pull-up-dev/tuto-kicad-temp-logger/tuto-kicad-temp-logger.kicad_pcb

## KiCad design tuto-kicad-temp-logger.kicad_pcb (2024-08-25)

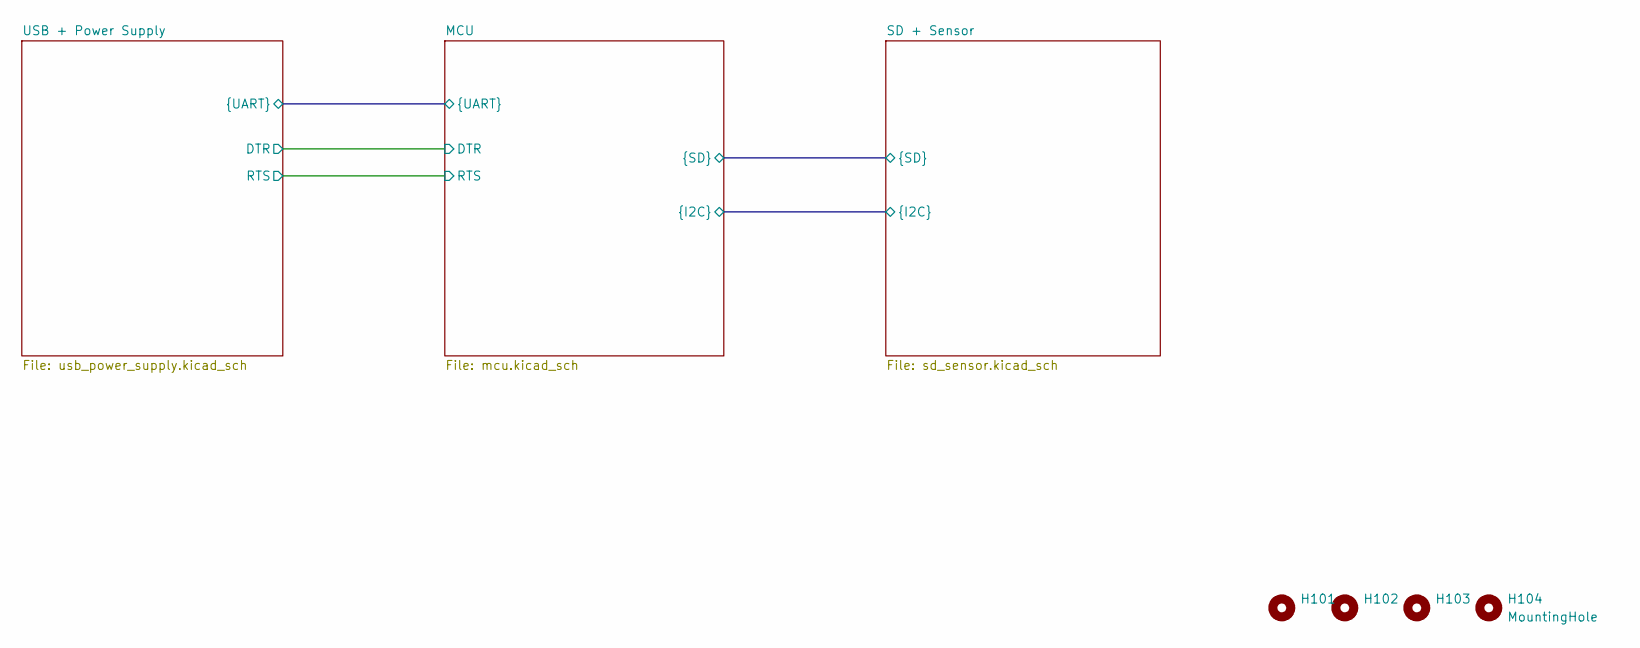
[picture p1: schematic tuto-kicad-temp-logger.kicad_sch, ${project_name} - Main]

Parts:
H101, H102, H103, H104: MountingHole; MountingHole_4.3mm_M4

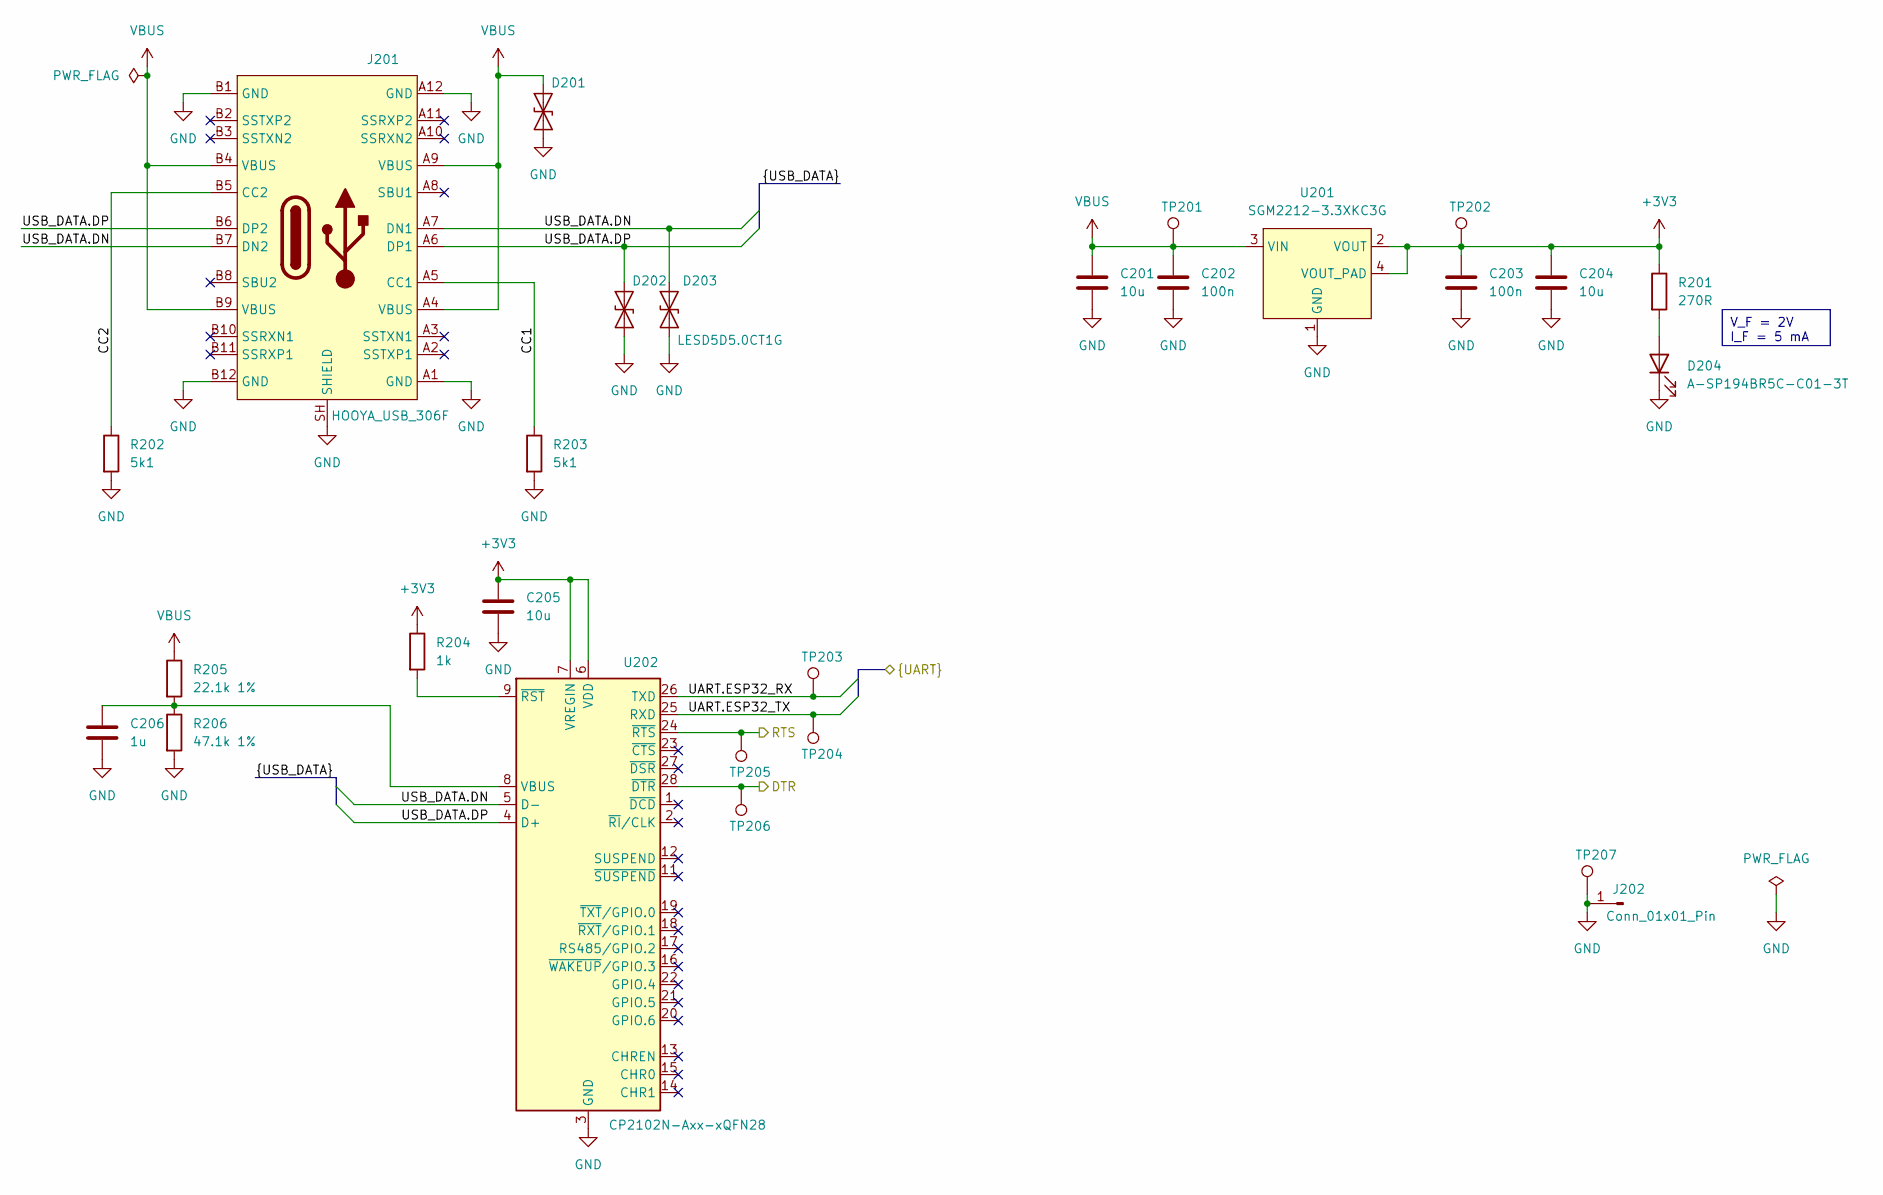
[picture p2: schematic usb_power_supply.kicad_sch, ${project_name} - USB + Power Supply]

Parts:
C201, C204, C205: 10u; C_0402_1005Metric
C202, C203: 100n; C_0402_1005Metric
C206: 1u; C_0402_1005Metric
D201, D202, D203: LESD5D5.0CT1G; D_SOD-523_non-pol
D204: A-SP194BR5C-C01-3T; LED_0603_1608Metric
J201: HOOYA_USB_306F
J202: Conn_01x01_Pin; PinHeader_1x01_P2.54mm_Vertical
R201: 270R; R_0402_1005Metric
R202, R203: 5k1; R_0402_1005Metric
R204: 1k; R_0402_1005Metric
R205: 22.1k 1%; R_0402_1005Metric
R206: 47.1k 1%; R_0402_1005Metric
TP201, TP202, TP203, TP204, TP205, TP206, TP207: TestPoint; TestPoint_Pad_D2.0mm
U201: SGM2212-3.3XKC3G; SOT-223
U202: CP2102N-Axx-xQFN28; QFN-28-1EP_5x5mm_P0.5mm_EP3.35x3.35mm

Connections:
+3V3: C203.1, C204.1, C205.1, R201.1, R204.1, TP202.1, U201.2 (VOUT), U201.4 (VOUT_PAD), U202.6 (VDD), U202.7 (VREGIN); also elsewhere on the board
/MCU/DTR: TP206.1, U202.28 (~DTR); also elsewhere on the board
/MCU/RTS: TP205.1, U202.24 (~RTS); also elsewhere on the board
/MCU/UART.ESP32_RX: TP203.1, U202.26 (TXD); also elsewhere on the board
/MCU/UART.ESP32_TX: TP204.1, U202.25 (RXD); also elsewhere on the board
/USB + Power Supply/CC1: J201.A5 (CC1), R203.1
/USB + Power Supply/CC2: J201.B5 (CC2), R202.1
/USB + Power Supply/USB_DATA.DN: D203.2 (A2), J201.A7 (DN1), J201.B7 (DN2), U202.5 (D-)
/USB + Power Supply/USB_DATA.DP: D202.2 (A2), J201.A6 (DP1), J201.B6 (DP2), U202.4 (D+)
GND: C201.2, C202.2, C203.2, C204.2, C205.2, C206.2, D201.1 (A1), D202.1 (A1), D203.1 (A1), D204.1 (K), J201.A1 (GND), J201.A12 (GND), J201.B1 (GND), J201.B12 (GND), J201.SH (SHIELD), J202.1, R202.2, R203.2, R206.2, TP207.1, U201.1 (GND), U202.3 (GND), U202.29 (GND); also elsewhere on the board
unnamed: D204.2 (A), R201.2
unnamed: C206.1, R205.2, R206.1, U202.8 (VBUS)
unnamed: R204.2, U202.9 (~RST)
VBUS: C201.1, C202.1, D201.2 (A2), J201.A4 (VBUS), J201.A9 (VBUS), J201.B4 (VBUS), J201.B9 (VBUS), R205.1, TP201.1, U201.3 (VIN)

Notes on the sheet:
V_F = 2V I_F = 5 mA

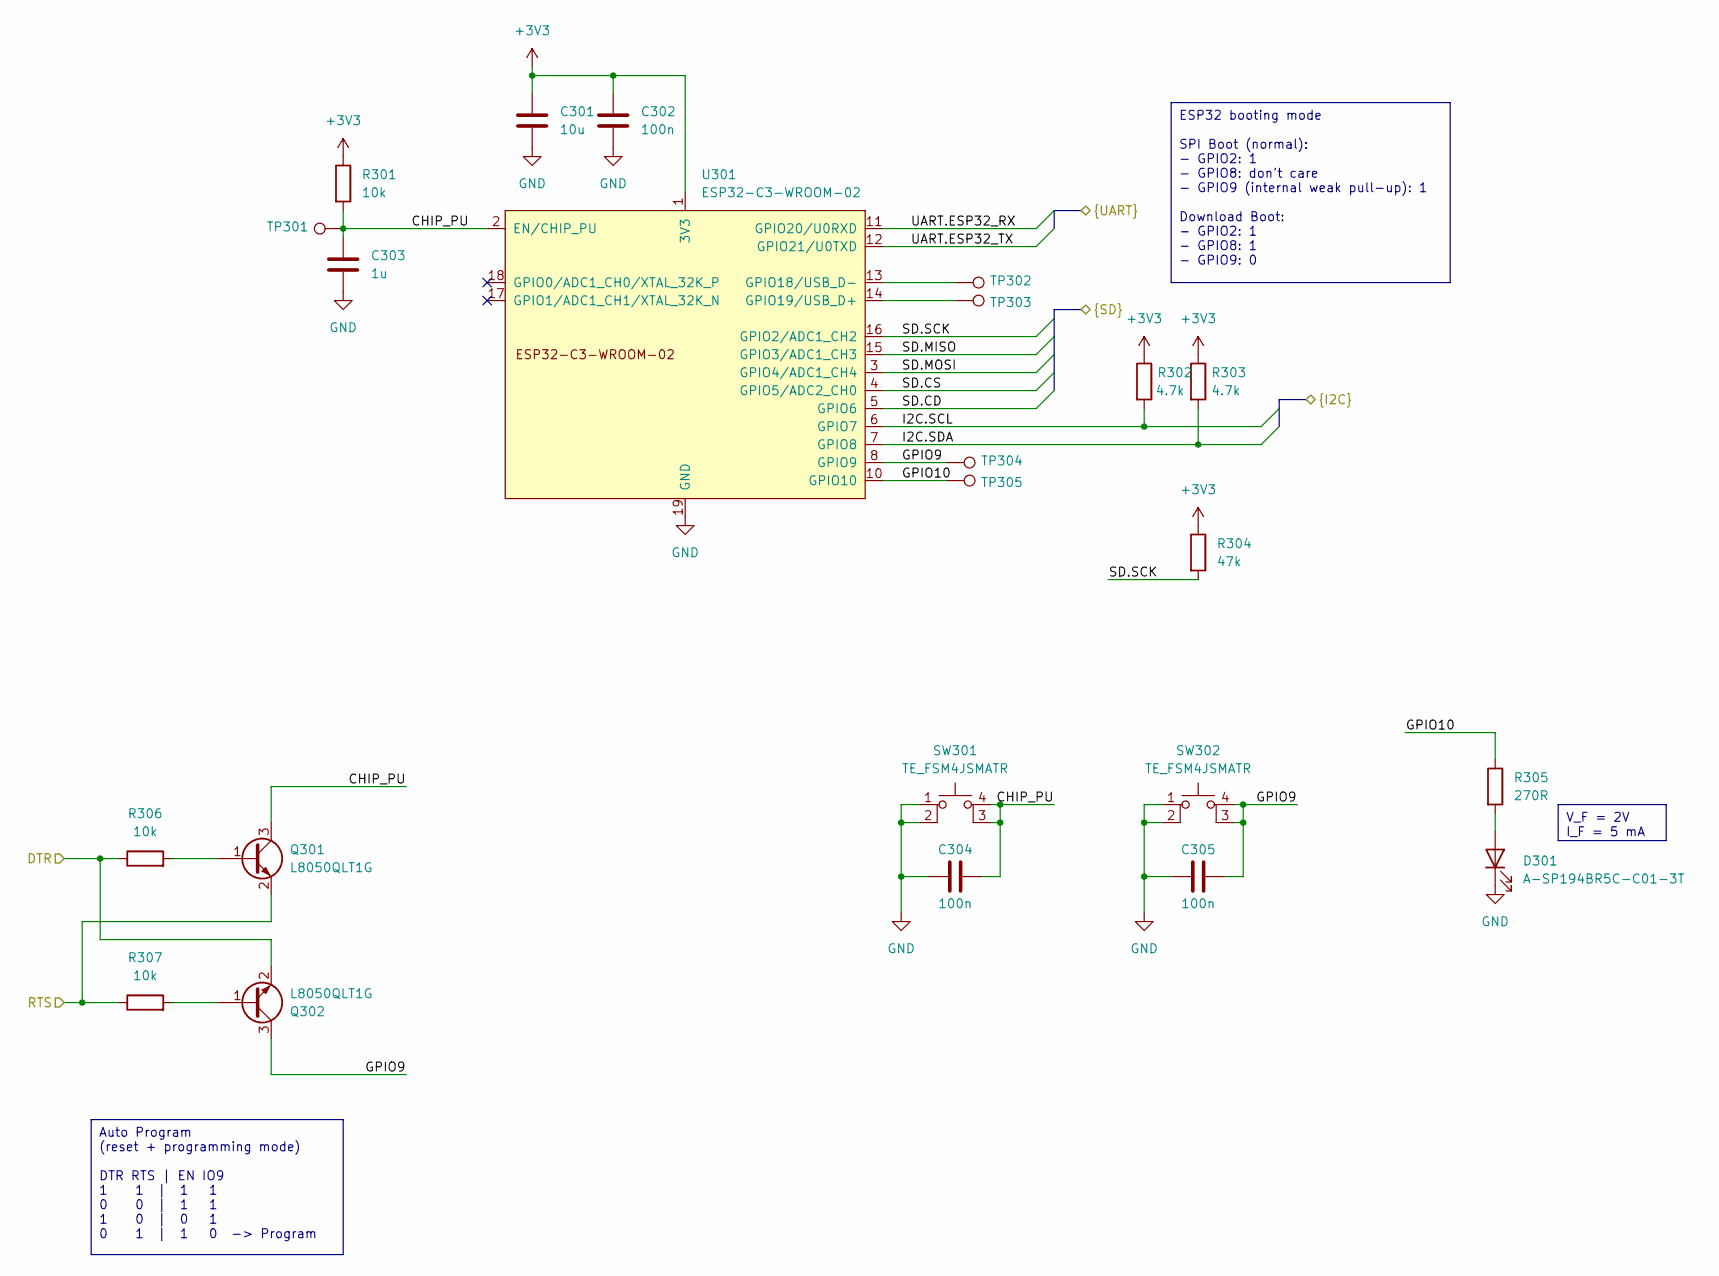
[picture p3: schematic mcu.kicad_sch, ${project_name} - MCU]

Parts:
C301: 10u; C_0402_1005Metric
C302, C304, C305: 100n; C_0402_1005Metric
C303: 1u; C_0402_1005Metric
D301: A-SP194BR5C-C01-3T; LED_0603_1608Metric
Q301, Q302: L8050QLT1G; SOT-23
R301, R306, R307: 10k; R_0402_1005Metric
R302, R303: 4.7k; R_0402_1005Metric
R304: 47k; R_0402_1005Metric
R305: 270R; R_0402_1005Metric
SW301, SW302: TE_FSM4JSMATR
TP301, TP302, TP303, TP304, TP305: TestPoint; TestPoint_Pad_D2.0mm
U301: ESP32-C3-WROOM-02

Connections:
+3V3: C301.1, C302.1, R301.1, R302.1, R303.1, R304.1, U301.1 (3V3); also elsewhere on the board
/MCU/CHIP_PU: C303.1, C304.2, Q301.3 (C), R301.2, SW301.3 (K), SW301.4 (A), TP301.1, U301.2 (EN/CHIP_PU)
/MCU/DTR: Q302.2 (E), R306.1; also elsewhere on the board
/MCU/GPIO9: C305.2, Q302.3 (C), SW302.3 (K), SW302.4 (A), TP304.1, U301.8 (GPIO9)
/MCU/GPIO10: R305.1, TP305.1, U301.10 (GPIO10)
/MCU/I2C.SCL: R302.2, U301.6 (GPIO7); also elsewhere on the board
/MCU/I2C.SDA: R303.2, U301.7 (GPIO8); also elsewhere on the board
/MCU/RTS: Q301.2 (E), R307.1; also elsewhere on the board
/MCU/SD.CD: U301.5 (GPIO6); also elsewhere on the board
/MCU/SD.CS: U301.4 (GPIO5/ADC2_CH0); also elsewhere on the board
/MCU/SD.MISO: U301.15 (GPIO3/ADC1_CH3); also elsewhere on the board
/MCU/SD.MOSI: U301.3 (GPIO4/ADC1_CH4); also elsewhere on the board
/MCU/SD.SCK: R304.2, U301.16 (GPIO2/ADC1_CH2); also elsewhere on the board
/MCU/UART.ESP32_RX: U301.11 (GPIO20/U0RXD); also elsewhere on the board
/MCU/UART.ESP32_TX: U301.12 (GPIO21/U0TXD); also elsewhere on the board
GND: C301.2, C302.2, C303.2, C304.1, C305.1, D301.1 (K), SW301.1, SW301.2, SW302.1, SW302.2, U301.9 (GND), U301.19 (GND); also elsewhere on the board
unnamed: D301.2 (A), R305.2
unnamed: Q301.1 (B), R306.2
unnamed: Q302.1 (B), R307.2
unnamed: TP302.1, U301.13 (GPIO18/USB_D-)
unnamed: TP303.1, U301.14 (GPIO19/USB_D+)

Notes on the sheet:
V_F = 2V I_F = 5 mA
ESP32 booting mode SPI Boot (normal): - GPIO2: 1 - GPIO8: don't care - GPIO9 (internal weak pull-up): 1 Download Boot: - GPIO2: 1 - GPIO8: 1 - GPIO9: 0
Auto Program (reset + programming mode) DTR RTS | EN IO9 1 1 | 1 1 0 0 | 1 1 1 0 | 0 1 0 1 | 1 0 -> Program

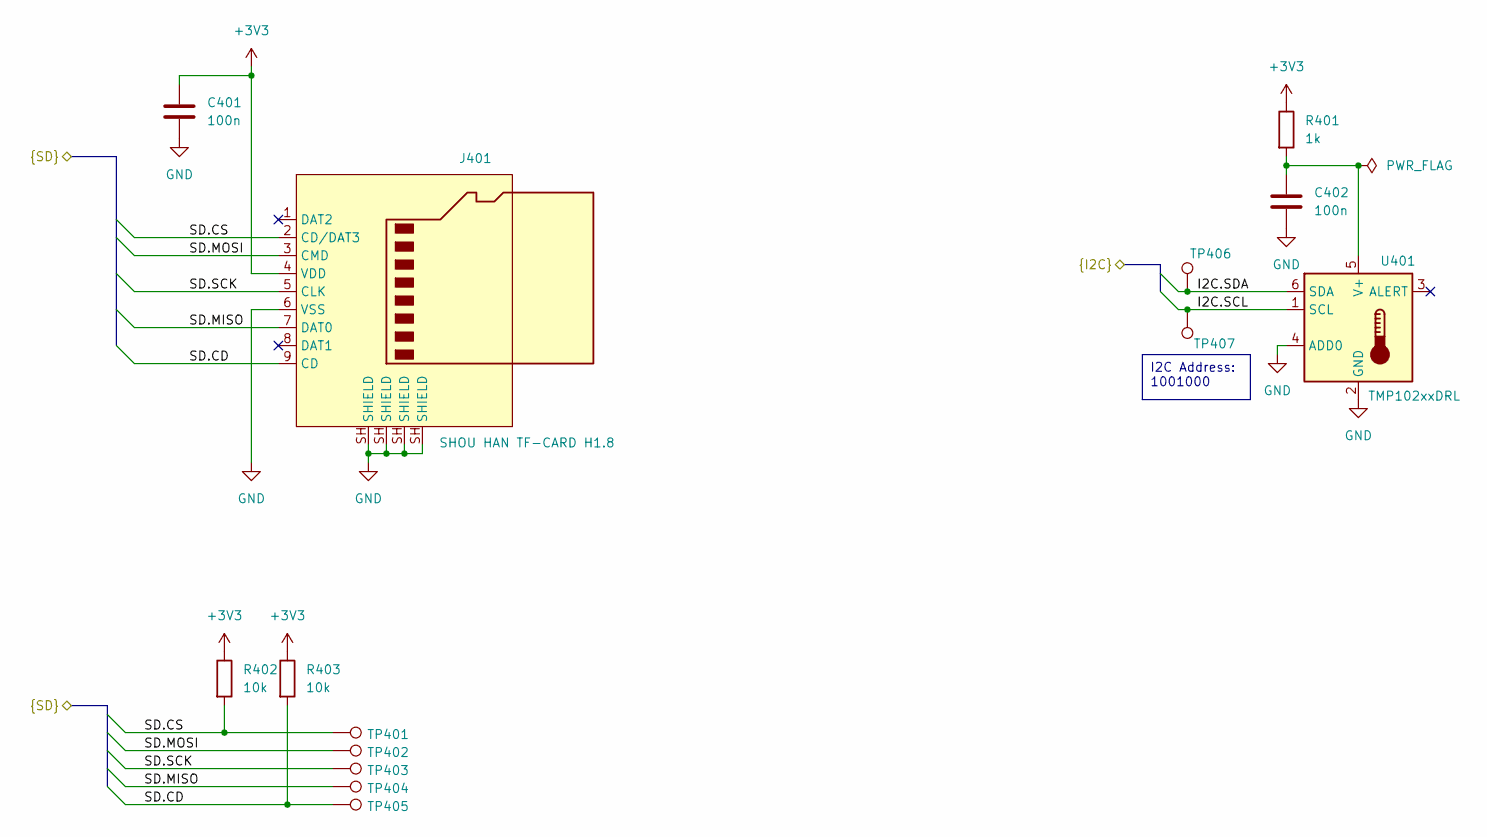
[picture p4: schematic sd_sensor.kicad_sch, ${project_name} - SD + Sensor]

Parts:
C401, C402: 100n; C_0402_1005Metric
J401: SHOU HAN TF-CARD H1.8; SHOUHAN_TF_CARD_H1.8
R401: 1k; R_0402_1005Metric
R402, R403: 10k; R_0402_1005Metric
TP401, TP402, TP403, TP404, TP405, TP406, TP407: TestPoint; TestPoint_Pad_D2.0mm
U401: TMP102xxDRL; SOT-563

Connections:
+3V3: C401.1, J401.4 (VDD), R401.1, R402.1, R403.1; also elsewhere on the board
/MCU/I2C.SCL: TP407.1, U401.1 (SCL); also elsewhere on the board
/MCU/I2C.SDA: TP406.1, U401.6 (SDA); also elsewhere on the board
/MCU/SD.CD: J401.9 (CD), R403.2, TP405.1; also elsewhere on the board
/MCU/SD.CS: J401.2 (CD/DAT3), R402.2, TP401.1; also elsewhere on the board
/MCU/SD.MISO: J401.7 (DAT0), TP404.1; also elsewhere on the board
/MCU/SD.MOSI: J401.3 (CMD), TP402.1; also elsewhere on the board
/MCU/SD.SCK: J401.5 (CLK), TP403.1; also elsewhere on the board
GND: C401.2, C402.2, J401.6 (VSS), J401.SH (SHIELD), U401.2 (GND), U401.4 (ADD0); also elsewhere on the board
unnamed: C402.1, R401.2, U401.5 (V+)

Notes on the sheet:
I2C Address: 1001000

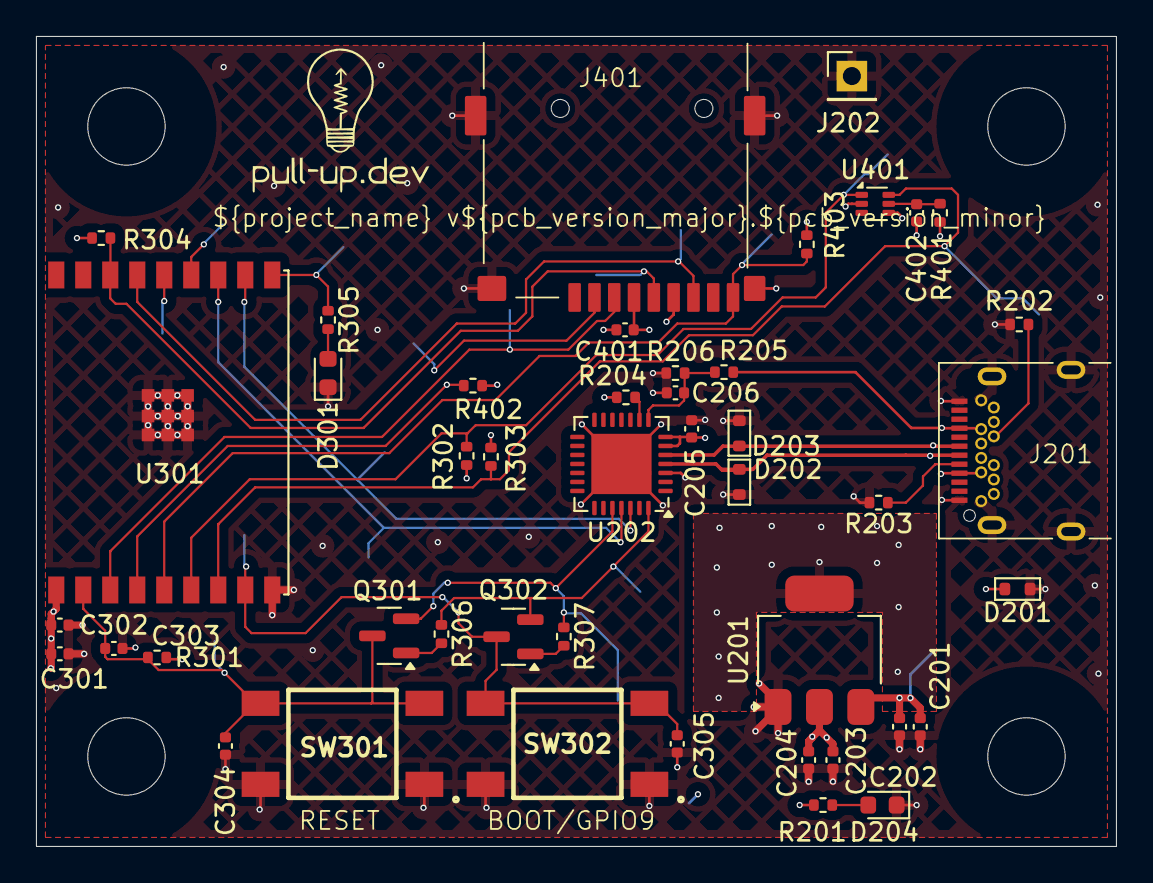
[picture p5: board tuto-kicad-temp-logger.kicad_pcb from above]

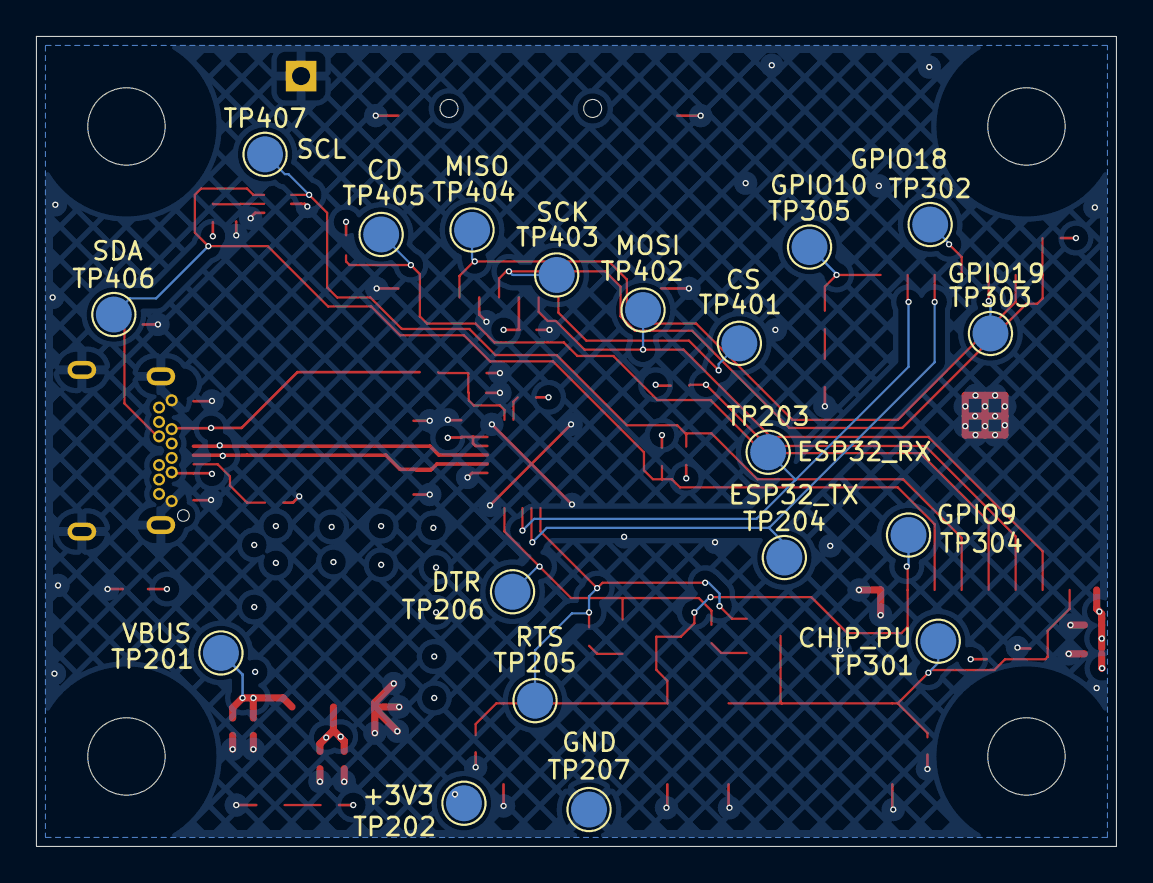
[picture p6: board tuto-kicad-temp-logger.kicad_pcb from below]

Board: 4 copper layers, 60.0 x 45.0 mm, 68 parts (19 on the bottom side), 30 nets.
