pull-up-dev/tuto-kicad-temp-logger/(commit log)

2024-07-07 Création du projet, ajout des pages, configuration
    [mcu.kicad_sch, sd_sensor.kicad_sch, tuto-kicad-temp-logger.kicad_pcb, tuto-kicad-temp-logger.kicad_sch, usb_power_supply.kicad_sch]
2024-07-07 Création des libraries de symboles et d'empreintes
2024-07-08 Ajouter composant LESD5D5.0CT1G (diode ESD)
2024-07-09 Ajouter composants: transistor NPN, régulateur de tension
2024-07-13 Ajouter composant: support de carte SD
2024-08-05 Ajout des composants et connexion page "USB + Power supply"
    [usb_power_supply.kicad_sch]
2024-08-10 Ajouter des composants + connexion page "MCU"
    [mcu.kicad_sch]
2024-08-10 Ajout des composants + connexion page "SD + Sensor"
    [sd_sensor.kicad_sch]
2024-08-10 Connexion des pages du schéma
    [sd_sensor.kicad_sch, tuto-kicad-temp-logger.kicad_sch]
2024-08-10 Vérification des règles électriques
    [mcu.kicad_sch, sd_sensor.kicad_sch, usb_power_supply.kicad_sch]
2024-08-10 Configuration du layout
    [tuto-kicad-temp-logger.kicad_pcb]
2024-08-11 Placement des composants
    [sd_sensor.kicad_sch, tuto-kicad-temp-logger.kicad_pcb, tuto-kicad-temp-logger.kicad_sch]
2024-08-12 Correction précoce d'erreurs de DRC: ajout de règles utilisateur
    [tuto-kicad-temp-logger.kicad_pcb]
2024-08-17 Ajout de plans hachurés au top et bottom
    [tuto-kicad-temp-logger.kicad_pcb]
2024-08-18 Ajout des annotations
    [tuto-kicad-temp-logger.kicad_pcb]
2024-08-25 Silkscreen, DRC et corrections
    [tuto-kicad-temp-logger.kicad_pcb]
2024-08-25 Placement de la référence
    [tuto-kicad-temp-logger.kicad_pcb]
